natecvt/Team-303/docs/Programming Resources.md

# Programming Resources

- [AprilTag Library](https://github.com/AprilRobotics/apriltag)
- [Python Socket Interface](https://docs.python.org/3/library/socket.html)
- [Python Docs](https://docs.python.org/3/)
