natecvt/Team-303/docs/mangraph.png

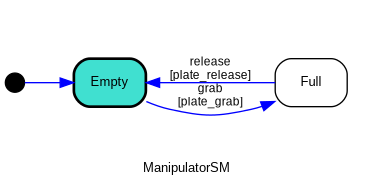
docs/mangraph.png
