natecvt/Team-303/docs/posgraph.png

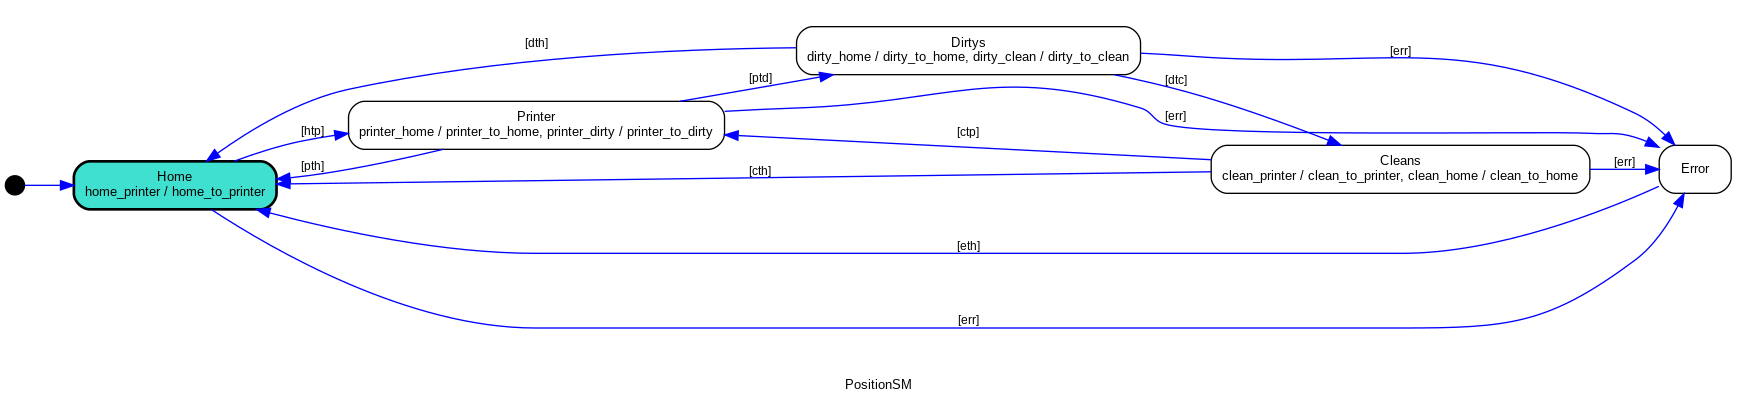
docs/posgraph.png
