natecvt/Team-303/Fusion Files/_Concept Workspace -NC.812245d1-37e7-4239-b554-420e8f00313b.png

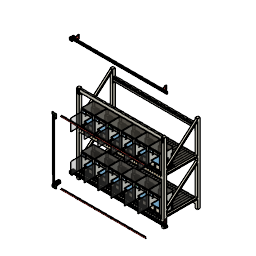
Fusion Files/_Concept Workspace -NC.812245d1-37e7-4239-b554-420e8f00313b.png
