natecvt/Team-303/Fusion Files/_Nate's Plate Dispenser.ac4d981b-2b22-4684-8131-7b73c1c8784d.png

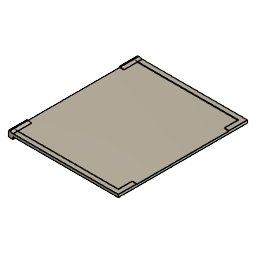
Fusion Files/_Nate's Plate Dispenser.ac4d981b-2b22-4684-8131-7b73c1c8784d.png
