natecvt/Team-303/Fusion Files/_Z Arm Copy.522619a4-56e4-46a4-9503-2a1cf247f2d2.png

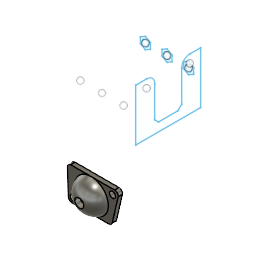
Fusion Files/_Z Arm Copy.522619a4-56e4-46a4-9503-2a1cf247f2d2.png
