natecvt/Team-303/Fusion Files/_Z Arm Copy_Component2.59cd4705-7b90-461e-99cb-14aab5ead7ad.png

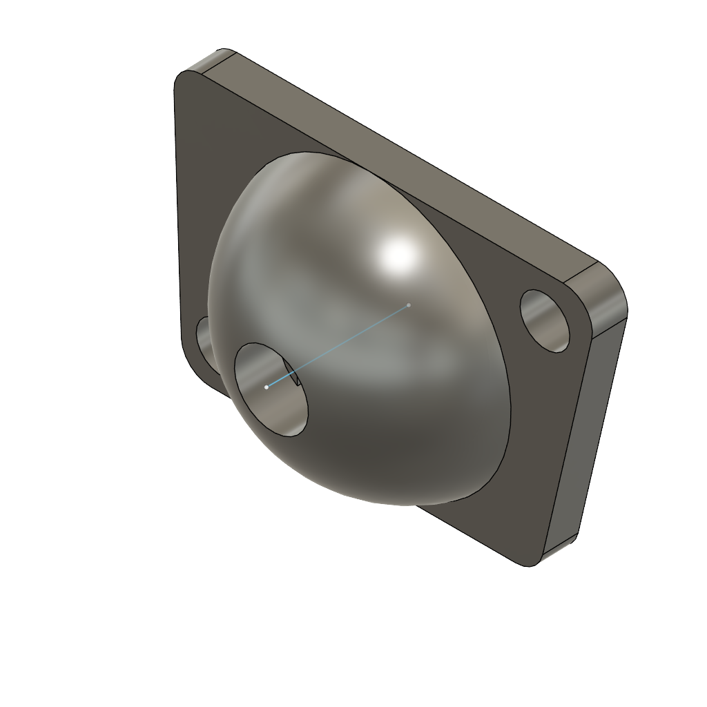
Fusion Files/_Z Arm Copy_Component2.59cd4705-7b90-461e-99cb-14aab5ead7ad.png
