natecvt/Team-303/(list of files, cad)

Other CAD files:
Fusion Files/_11435A13 Steel Drawer Slides.f201e1a2-71bf-47c2-941a-5dbec80e6ac8.f3d
Fusion Files/_1524-0001-0001 assembly.d8f83b15-5d64-45f2-8464-23ac5ebec497.f3d
Fusion Files/_1MEX1AUDCOXB63RKXOONYMDRDen-US11.871f0460-c664-4760-81d9-ae601f0fbb97.f3d
Fusion Files/_1_4_ x 1-1_2_ x 48_ Wood.e3c73d7b-7f3b-413b-bdec-7eca03abb7ca.f3d
Fusion Files/_2020 Extrusion.d20cdcef-b238-4049-98ed-29df6a03594f.f3d
Fusion Files/_2CWA9TJD5Y5ZICN82B6K2HIVUen-US11.b4c415c8-f10c-463e-afa1-e01077a5fb48.f3d
Fusion Files/_2LRKZU0XQ3TFWOJJPE8VZ6TH7en-US11.e4896452-3879-4eb4-a955-ac26621a7747.f3d
Fusion Files/_2YGZ0ALZRLHQGKKM6CFQO6XRRen-US11.6d42b6b1-727e-4e6d-b5a9-baa54112e666.f3d
Fusion Files/_2x4 board.d99266e9-60ea-4329-bf0e-f758237543eb.f3d
Fusion Files/_3030 Angle Bracket.8fdec9af-f8a9-4786-83be-04986f9cd556.f3d
Fusion Files/_30mm x 60mm Profile v4.02e2be94-0d6a-477b-a073-dc361f5778b3.f3d
Fusion Files/_34HP29-6004S.21105655-74dc-47f4-a5a2-57e6708c8cfd.f3d
Fusion Files/_34HS38-4204D.5b6d3bde-a94a-41b2-8553-8acd5e45f75a.f3d
Fusion Files/_3DBenchy.6bf22c53-5d7d-44a3-8f2e-c1a7761ff799.f3d
Fusion Files/_4OEEJIF0B9PPVZ418O6PRQBIKen-US11.62161f97-23c2-4399-a1da-700cbc7e6848.f3d
Fusion Files/_5-Axis_interface_Board.dd792416-b463-42a2-9a4e-d865812135e1.f3d
Fusion Files/_608_bearing_loose Drawing.7d569181-074e-4e86-8065-ec56b04d2bd5.f2d
Fusion Files/_608_bearing_loose Drawing.fba835c8-0b00-4eb9-9039-403241976642.f2d
Fusion Files/_608_bearing_loose.4b137e7b-a010-4bac-929f-4559a8e0e562.f3d
Fusion Files/_6121 TMC2209 Driver.b4bf99a3-9f4d-47f9-b455-627c43442d4c.f3d
Fusion Files/_8KEYWE6RKB4RY3AVARTBXGBUTen-US11.58c39408-2f88-4fb6-8834-311d7a520ea7.f3d
Fusion Files/_AF2L2LL72Y6KH69GZKG6OXJIJen-US11.b8a858b2-0cdd-422f-bf79-8eb3990d1fa5.f3d
Fusion Files/_APEX_AB090A.dff36a9a-ec71-4ef7-bbd9-a6e3a0eaae9f.f3d
Fusion Files/_ARZAPX611HE4EJA0GVGFHWCEDen-US11.91fedfdf-b78a-491f-80bd-0d916006fc69.f3d
Fusion Files/_Acryllic Bottom Panel.a2e647fa-4541-49cd-8f14-f221a0b68c71.f3d
Fusion Files/_Alumunium Profile 3030.5e9db2a2-b4c8-4faa-b999-057ec7ec6fd7.f3d
Fusion Files/_Animation Test Print.c652fa5c-e650-4809-80f6-2eb2ca7b7716.f3d
Fusion Files/_BEARING.36e73cc2-2726-468c-967d-a39445ba801f.f3d
Fusion Files/_BED LIFTER v6.47b509fa-7b62-4dd1-9dec-8417c735d87a.f3d
Fusion Files/_Bambu X1C.0ba0961a-6383-4ad6-a3a4-08fed4a4a26a.f3d
Fusion Files/_Bambu X1C.2f27f083-a404-4860-91cc-b01bfa1a344a.f3d
Fusion Files/_Bambu X1C.ee5c8159-9735-4650-8eb5-f683d6820118.f3d
Fusion Files/_BarBeam.5c540dc0-49b3-424c-a6fa-f8eb28995f75.f3d
Fusion Files/_Bearing Assembly.18e97cce-70fd-4f5a-a665-227e1e79b88c.f3d
Fusion Files/_Bearing Assembly.c613765f-da20-447d-8ce3-f9d2aa04a9a1.f3d
Fusion Files/_Bearing.9ad38aa8-b4c1-4b58-a255-3b9564d2ce1e.f3d
Fusion Files/_Belt Tension Spacer Drawing.256da694-22c8-4e23-9ec9-d312e222b278.f2d
Fusion Files/_Belt Tension Spacer.d0077247-6966-45b5-a952-ba4797ad4160.f3d
Fusion Files/_Bolt Ramp Cover.b14d74ff-13b3-4bcc-bf03-41ef3c5aef0e.f3d
Fusion Files/_Bottom Grip Drawing.aa5d0a74-4aea-4fbf-97d2-10af25b1910b.f2d
Fusion Files/_Bottom Grip.d06de344-5b7f-4842-80e2-1f2c50bef981.f3d
Fusion Files/_Bottom Gripper - PETG.6541a5cc-7aaf-420e-b20c-d6b1b9675311.f3d
Fusion Files/_Bushing.d676b754-ac8c-492a-baaf-132cd2dec664.f3d
Fusion Files/_CBDV84A8I0WL1YNSBZLN71LCOen-US11.f75e25f6-2e55-49c4-8258-774282cb3d49.f3d
Fusion Files/_Carriage - PLA.e418e02d-878d-4828-aee4-d5c6400d76ea.f3d
Fusion Files/_Carriage.0b2b4e1a-04e9-4fef-95d4-fc130978fd02.f3d
Fusion Files/_Center Disk - PLA(UNPRINTED).b0c9f04e-1c23-4f4a-89ec-b8c6ccbb50af.f3d
Fusion Files/_Clean Plate Dispenser IV.00e3d409-83d6-4102-95ea-da3b694405df.f3d
Fusion Files/_Clean Plate Dispenser Mk I.d888115d-f9dc-4e2e-b37e-09149f3ba2da.f3d
Fusion Files/_Clean Plate Dispenser Mk II.aa286063-0900-4341-9739-145c506a401d.f3d
Fusion Files/_Clean Plate Dispenser Mk II.c28ebf26-b3f7-4ca9-b64e-0c7db7e6fd58.f3d
Fusion Files/_Clean Plate Dispenser Mk III -CB.3465c587-4609-48bf-b0e1-33bd404df41b.f3d
Fusion Files/_Clean Plate Dispenser Mk III.bc16b3c2-3918-4c6a-9620-ba4c95044fed.f3d
Fusion Files/_Clean Plate Dispenser Mk IV.07862242-1453-423a-8027-b55cac08dfaa.f3d
Fusion Files/_Clean Plate Dispenser Mk VI.50b04678-366e-420a-94e1-b5dc8567d541.f3d
Fusion Files/_Clean Plate Dispenser Mk VI.872e23aa-c2f2-444b-ac29-6d9ff279327c.f3d
Fusion Files/_Clean Plate Dispenser Mk VI.986346c8-7c10-4720-974b-1816f312ca2f.f3d
Fusion Files/_Clean Plate Dispenser Mk VII Drawing.3a0c4c97-41eb-437a-b866-73dc83d58730.f2d
Fusion Files/_Clean Plate NEMA 17 w_ Lead Screw.d50ca21d-fa27-44c8-b5f9-0d5c7d1bbd7b.f3d
Fusion Files/_Clean Plate Shelf Board.2b175231-a27d-466f-826b-acb84cc05703.f3d
Fusion Files/_Concept Workspace -CB_CPD & E-Shelf.488b2424-6ffc-4902-bf2d-4ff15675e1c4.f3d
Fusion Files/_Connecting Bracket - PETG(UNPRINTED).d62f7203-87be-4ffc-b4af-6a76f50e32fd.f3d
Fusion Files/_Connecting Bracket and Door Peg - PETG.c4a71934-b0d0-4ee0-bcbc-1e1dc2b2d839.f3d
Fusion Files/_Corner Mount (BL) - PLA(UNPRINTED).6a92bf0e-be94-499f-afa5-f4096df500e7.f3d
Fusion Files/_Corner Mount (BR) - PLA(UNPRINTED).cc1ebedb-9e60-4fe5-a2ff-01e3a96ac505.f3d
Fusion Files/_Corner Mount (FL) - PLA(UNPRINTED).6153c898-196f-4466-89e3-3e98568611da.f3d
Fusion Files/_Corner Mount (FR) - PLA(UNPRINTED).944a5cd2-0263-4eac-8404-031c68dc65f3.f3d
Fusion Files/_Cross Bar.9fb02594-36a0-4474-9139-e6fe5210b81d.f3d
Fusion Files/_Cryogrip Pro Glacier Print Plate.e03662f8-7f37-4dec-8051-359863a2ac5f.f3d
Fusion Files/_D6H5TS5AVR8F43N3R1XL613M4en-US11.c9319d48-3e45-4f47-b580-171f8668bec4.f3d
Fusion Files/_DC–DC Converter (Output—12V20A).7ef1258a-59f4-465b-95e3-1039faef6fbb.f3d
Fusion Files/_DM860D.acb2b8d5-bf62-48d1-a249-f7f316a14808.f3d
Fusion Files/_Dirty Plate Panel Assembly (Double Sided).1f15971e-c9f7-46a8-bb4e-32e216f44586.f3d
Fusion Files/_Dirty Plate Panel Assembly (Left End).fb309c1f-d267-43c5-8591-1b8af36e7ebe.f3d
Fusion Files/_Dirty Plate Panel Assembly (Right End).6586db5a-2d80-4c8e-9abb-96794e564158.f3d
Fusion Files/_Door Peg - PETG(UNPRINTED).eb54a9cc-154b-4bd0-99ef-7f5174c7dbb0.f3d
Fusion Files/_Door Peg Arm Drawing.d310bc12-9456-4d6b-a5a6-582d7c525310.f2d
Fusion Files/_Door Peg Arm.c15aca6d-5e2f-43a4-9bdd-879f0cbf9eb8.f3d
Fusion Files/_Door Peg Drawing.fe2e4660-0dbb-4004-984a-58babb9493bb.f2d
Fusion Files/_Door Peg.04528239-56f7-4be8-bebd-5ac3028784df.f3d
Fusion Files/_Door handle.e58d4f98-5379-45a3-b839-1e9d1d2cf471.f3d
Fusion Files/_DoorHandle Drawing.80f49713-780c-46c9-81b8-1306e775f9b3.f2d
Fusion Files/_DoorHandle.e51096b4-f168-460e-9366-637bbbfa7daa.f3d
Fusion Files/_Drawer Slide Platform Drawing.74e53d03-3bf8-4873-bbfd-aae8dae7872d.f2d
Fusion Files/_Drawer Slide Platform Drawing.bd870e49-7afc-483a-8d96-bc4633aa2fe3.f2d
Fusion Files/_Drawer Slide Platform.ed80e009-23af-4e0c-9145-038d78873132.f3d
Fusion Files/_EStop Mount.2c2b779b-0f7c-4221-b780-935d777d9daa.f3d
Fusion Files/_EStop_LA38 _203 209B.204cfa63-6cc7-4e90-86a4-f45930ce202f.f3d
Fusion Files/_F4VPWOYM75PIA5HG82ETZLPW2en-US11.d6342356-7cd7-46d0-9618-566e6af3abb9.f3d
Fusion Files/_Final Assembly.d5e50cc4-fbbf-425d-9114-7c4eaf0d9d1f.f3d
Fusion Files/_Forklift Gripper.6b1c0e55-7617-40bb-bc85-293bfe7535c7.f3d
Fusion Files/_Forklift Gripper.78eb993c-dedf-4589-a54b-33957d6280ca.f3d
Fusion Files/_Forklift Gripper.8774358a-8fbf-4f9f-a7da-25711d0c93cd.f3d
Fusion Files/_Forklift Gripper.9c7cf6f4-ab22-4ea9-99b3-d0b801f71103.f3d
Fusion Files/_Forklift Gripper.aff1238d-7b78-4385-8f14-e939a9be44ff.f3d
Fusion Files/_GT2 Aluminum Timing Belt Clamp.340c6122-af78-4eda-ad23-d4842b9db6dc.f3d
Fusion Files/_GT2_30T_8mm-Bore_6mm-Belt v2.571befc2-2a2b-4837-bd41-15348b01cf62.f3d
Fusion Files/_GT2_30T_8mm-Bore_6mm-Belt v2.9e95242d-53cf-47ee-bd2e-521d65de6457.f3d
Fusion Files/_GT2_Belt_Tensioner_2020.30771677-e502-4594-9bbf-6fb2553483e7.f3d
Fusion Files/_GT2_Belt_Tensioner_2020.92cd986f-2bba-4732-beba-4abccc0f6408.f3d
Fusion Files/_Gantry Assembly.24bbb05c-2e5b-47de-b62c-a8f817f25a81.f3d
Fusion Files/_Gantry Carriage Drawing.be659053-b998-46e8-ba02-e66b1a41b0d9.f2d
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
