natecvt/Team-303/Fusion Files/_Y Axis + Z Axis Assembly.4d20c737-85af-49aa-a7bc-ecfc3bc29eaa.png

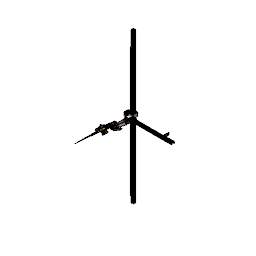
Fusion Files/_Y Axis + Z Axis Assembly.4d20c737-85af-49aa-a7bc-ecfc3bc29eaa.png
