natecvt/Team-303/ref_files/config.yaml

axis_x_max: 2740.0
axis_y_max: 1220.0
axis_z_max: 420.0
camera_fov_height: 40.0
camera_fov_length: 50.0
camera_global_transform:
- x: -70.6
- y: 64.5
- z: 50.0
camera_transform_coeffs:
- x: -50.0
- y: -15.0
clean_plate_axis: v
clean_plate_distance: 215.0
cs_amount: 5
cs_coords:
  x: 2353.007433437003
  y: 755.7050812168577
cs_grab_y: -30.0
cs_grab_z: 350.9547763247974
cs_tag_id: 0
door_close_delta:
  x: 325.0
  y: 0.0
  z: 283.0
door_close_x_offset: 15.0
door_into_y: 35.0
door_open_delta:
  x: -340.0
  y: 0.0
  z: -280.0
door_radius: 310.0
door_to_plate_delta:
  x: -50.0
  y: 68.0
  z: 0.0
door_z: 395.0
ds_amount_per: 4
ds_angle: -13.0
ds_cols: 6
ds_cols_coords:
  1:
    x: 0.1
    y: 0.1
  2:
    x: 0.1
    y: 0.1
  3:
    x: 0.1
    y: 0.1
  4:
    x: 0.1
    y: 0.1
  5:
    x: 0.1
    y: 0.1
  6:
    x: 0.1
    y: 0.1
  7:
    x: 0.1
    y: 0.1
ds_coords:
  x: 377.86305188340134
  y: 778.1307565171763
ds_dx: 277.53408903693594
ds_dy: -81.22026800002561
ds_release_dy: -10.0
ds_release_z: 375.0
ds_rows: 4
feed_rate: 3000.0
gripper_axis: u
gripper_down: -15.1
gripper_up: 13.0
heartbeat_duration: 30.0
linuxcnc_folder: linuxCNC/team303_machine.ini
linuxcnc_timeout: 240.0
manipulator_angle_0: 895.0
manipulator_angle_90: 100.0
manipulator_angle_n12: 950.0
mqtt_acknowledge_topic: test/ack
mqtt_broker_ip: localhost
mqtt_complete_topic: test/complete
mqtt_error_topic: test/error
mqtt_heartbeat_topic: test/heartbeat
mqtt_keepalive: 120
mqtt_received_topic: test/topic
mqtt_storage_topic: test/storage
printer_coords:
  1:
    x: 486.3253384055591
    y: 37.88888240607261
  2:
    x: 1887.015173546095
    y: -5.289912223815918e-06
printer_plate_z: 340.0
tolerance: 0.5
