natecvt/Team-303/linuxCNC/team303_machine.ini

# Generated by stepconf 1.1 at Wed Oct 18 19:03:20 2023
# If you make changes to this file, they will be
# overwritten when you run stepconf again
# max speed should be 715mm/minute or 12mm per second

[EMC]
MACHINE = cncRouter
DEBUG = 0
VERSION = 1.1

[DISPLAY]
DISPLAY = axis
EDITOR = gedit
POSITION_OFFSET = RELATIVE
POSITION_FEEDBACK = ACTUAL
ARCDIVISION = 64
GRIDS = 10mm 20mm 50mm 100mm 1in 2in 5in 10in
MAX_FEED_OVERRIDE = 1.2
MIN_SPINDLE_OVERRIDE = 0.5
MAX_SPINDLE_OVERRIDE = 1.2
DEFAULT_LINEAR_VELOCITY = 25.4
MIN_LINEAR_VELOCITY = 0
MAX_LINEAR_VELOCITY = 75.0
CYCLE_TIME = 0.200
INTRO_GRAPHIC = linuxcnc.gif
INTRO_TIME = 5
PROGRAM_PREFIX = /home/cnc/linuxcnc/nc_files
INCREMENTS = 5mm 1mm .5mm .1mm .05mm .01mm .005mm

[KINS]
#JOINTS = 3
#KINEMATICS = trivkins coordinates=XYZ
JOINTS = 5
KINEMATICS = trivkins coordinates=XYZUV

[FILTER]
PROGRAM_EXTENSION = .png,.gif,.jpg Greyscale Depth Image
PROGRAM_EXTENSION = .py Python Script
PROGRAM_EXTENSION = .nc,.tap G-Code File
png = image-to-gcode
gif = image-to-gcode
jpg = image-to-gcode
py = python

[TASK]
TASK = milltask
CYCLE_TIME = 0.010

[RS274NGC]
PARAMETER_FILE = linuxcnc.var

[EMCMOT]
EMCMOT = motmod
COMM_TIMEOUT = 1.0
BASE_PERIOD = 100000
SERVO_PERIOD = 660000

[HAL]
HALFILE = team303_machine.hal
HALFILE = custom.hal
POSTGUI_HALFILE = postgui_call_list.hal

[TRAJ]
#COORDINATES =  X Y Z
COORDINATES =  X Y Z U V
LINEAR_UNITS = mm
ANGULAR_UNITS = degree
DEFAULT_LINEAR_VELOCITY = 10.0
MAX_LINEAR_VELOCITY = 75.0

[EMCIO]
EMCIO = io
CYCLE_TIME = 0.100
TOOL_TABLE = tool.tbl

#*** AXIS_X *******************************
#STEPGEN_MAXACCEL should be up to 10% more than MAX_ACCELERATION
#MAX_VELOCITY is mm/s, MAX_ACCELERATION is mm/s^2
[AXIS_X]
MAX_VELOCITY = 75.0
MAX_ACCELERATION = 400.0
MIN_LIMIT = -1.0
MAX_LIMIT = 2740.0

[JOINT_0]
TYPE = LINEAR
HOME = 0.0
MIN_LIMIT = -1.0
MAX_LIMIT = 2740.0
MAX_VELOCITY = 75.0
MAX_ACCELERATION = 400.0
STEPGEN_MAXACCEL = 480.0
SCALE = -17.88
STEP_SCALE = -17.88
FERROR = 1.270
MIN_FERROR = .254
HOME_OFFSET = 0.0
HOME_SEARCH_VEL = -48.0
HOME_LATCH_VEL = 2
HOME_FINAL_VEL = 2
HOME_SEQUENCE = 1
#******************************************

#*** AXIS_Y *******************************
[AXIS_Y]
MAX_VELOCITY = 75.0
MAX_ACCELERATION = 400.0
MIN_LIMIT = -0.1
MAX_LIMIT = 1220.0

[JOINT_1]
TYPE = LINEAR
HOME = 0.0
MIN_LIMIT = -0.1
MAX_LIMIT = 1220.0
MAX_VELOCITY = 75.0
MAX_ACCELERATION = 400.0
STEPGEN_MAXACCEL = 480.0
SCALE = 17.88
FERROR = 1.270
MIN_FERROR = .254
HOME_OFFSET = 0.0
HOME_SEARCH_VEL = -48.0
HOME_LATCH_VEL = 2
HOME_FINAL_VEL = 2
HOME_SEQUENCE = 1
#******************************************

#*** AXIS_Z *******************************
[AXIS_Z]
MAX_VELOCITY = 75.0
MAX_ACCELERATION = 400.0
MIN_LIMIT = -0.1
MAX_LIMIT = 420.0

[JOINT_2]
TYPE = LINEAR
HOME = 0.0
MIN_LIMIT = -0.1
MAX_LIMIT = 420.0
MAX_VELOCITY = 75.0
MAX_ACCELERATION = 400.0
STEPGEN_MAXACCEL = 480.0
SCALE = -40
FERROR = 1.270
MIN_FERROR = .254
HOME_OFFSET = 0.0
HOME_SEARCH_VEL = -48.0
HOME_LATCH_VEL = 2
HOME_FINAL_VEL = 2
HOME_SEQUENCE = 0
#******************************************

#*** AXIS_U *******************************
[AXIS_U]
MAX_VELOCITY = 12.0
MAX_ACCELERATION = 100.0

[JOINT_3]
TYPE = LINEAR
HOME = 0.0
MAX_VELOCITY = 12.0
MAX_ACCELERATION = 100.0
STEPGEN_MAXACCEL = 120.0
SCALE = 160
STEP_SCALE = 160
FERROR = 1.270
MIN_FERROR = .254
#HOME_OFFSET = 0.0
#HOME_SEARCH_VEL = -10
#HOME_LATCH_VEL = 2
#HOME_FINAL_VEL = 2
# Disregard homing for this axis - not needed 
HOME_SEQUENCE = -1 
#******************************************

#*** AXIS_V *******************************
[AXIS_V]
MAX_VELOCITY = 12.0
MAX_ACCELERATION = 100.0

[JOINT_4]
TYPE = LINEAR
HOME = 0.0
MAX_VELOCITY = 12.0
MAX_ACCELERATION = 100.0
STEPGEN_MAXACCEL = 120.0
SCALE = 198.0
STEP_SCALE = -198.0
FERROR = 1.270
MIN_FERROR = .254
#HOME_OFFSET = 0.0
#HOME_SEARCH_VEL = -10
#HOME_LATCH_VEL = 2
#HOME_FINAL_VEL = 2
# Disregard homing for this axis - not needed 
HOME_SEQUENCE = -1
#******************************************
