natecvt/Team-303/(commit log)

2025-09-30 Uploaded a script for sizing stepper motors
2025-10-09 Added electrical peak script and input data
    [Electrical_Devices_Peaks.xlsx]
2025-10-10 Create Virginia Tech Gantry Integration - Interface Requirements Document
2025-10-10 Rename Virginia Tech Gantry Integration - Interface Requirements Document to Virginia Tech Gantry Integration - Interface Requirements Document.md
2025-10-10 Create Virginia Tech Gantry Automation - Implementation Guide.md
2025-10-31 Fixed stuff a little more
    [printer_centers.csv]
2025-10-31 Added the ability to see which printer is done and create a log file if an eror occurs.
2025-10-31 Fixed a couple things I had added previously.
2025-10-31 Added actions file to compile coordinates into gcodes
    [printer_centers.csv]
2026-03-21 Added LinuxCNC config files
    [team303_machine.hal, team303_machine.ini]
2026-03-21 Edited HAL and INI files and confirmed 5-axis works, still need PWM
    [team303_machine.hal]
2026-03-25 Added more functions to gantry_actions.py and more variables in config.yaml in ref files. Also changed gcode_gen slighty for the clockwise and counter-clockwise M codes
2026-03-27 mostly updated lcnc files
    [team303_machine.hal, team303_machine.ini]
2026-03-27 Fixed linuxcnc interface errors, confirmed python starts linuxcnc. Added all configurations to linuxcnc folder.
    [custom.hal, custom_postgui.hal, postgui_call_list.hal, pyvcp_options.hal]
2026-03-27 Created homing function and added entries to config
2026-03-27 Added MDI command interface and error checking. Updated config with a timeout, and fixed a bug in queue that only uses the test_loop in the worker thread
    [config.yaml]
2026-03-27 Fixed some things, confirmed functions
    [team303_machine.ini]
2026-03-29 Bunch of changes, started to implement apriltag autocalibration, fixed some issues with some sections, added much to the config file
    [config.yaml]
2026-03-30 Finalized testable auto-calibration functionality, and added coordinates writeable to config
    [printer_centers.csv]
2026-04-01 Added state machine functions, modified gantry actions to have a generic move, added some to config and storage tracker
2026-04-01 Started main file, modified some functions to prevent errors, tested multithreading capability
    [team303_machine.hal, team303_machine.ini]
2026-04-01 Added pseudo code for clean plate grab/release and position state machine and removed one redundant state transition
2026-04-02 Minor changes, converted gantry actions format to return a list of strings rather than one long one, created loop for multiple MDI lines
2026-04-03 Added function to modify config during runtime, added G17-19 in gcode gen, added function to check if z is zero in linuxcnc, reformatted gantry actions to include some checks, added constants read in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
2026-04-03 Added plate grabbing and fixed a few bugs in gcode gen
    [config.yaml]
2026-04-06 Gantry motions finalized
    [team303_machine.hal, team303_machine.ini]
2026-04-07 Main loop started, added some functionality to error message, changed state machine a bit
    [config.yaml]
2026-04-09 Safer linuxcnc modifications
    [team303_machine.hal]
2026-04-11 Added testing stuffs, implemented new mqtt messages, reformatted some threading code, added heartbeat thread, generalized publishing, added script for subscribing to many simultaneous mqtt topics
2026-04-11 Delay in heartbeat loop, would've published too much without
    [config.yaml]
2026-04-11 Clarify threading model and heartbeat functionality
    Updated the number of threads in the system description to three and added details about the heartbeat thread's functionality.
2026-04-13 Minimal modifications, seperated storage reset topic from normal sc, improcing storage handling. Fixed some bugs on outgoing messages. Changed ESTOP to home after errors. Added an Error state to stat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
    [config.yaml]
2026-04-15 Update error message clarification in README
    Clarified error message for full plate storage condition in README.
2026-04-15 Add configuration documentation for MQTT and printers
    This file outlines configuration values for MQTT and printer settings, including topics and movement parameters for the manipulator.
2026-04-19 Added calibration script
2026-04-20 Testing modifications, calibration script tentatively complete
2026-05-01 Modified calibration script for different functionality, added descriptions to the User Manual
2026-05-02 Modifications to add Apriltag functionality to calibration
2026-05-02 testing modifications
    [team303_machine.ini]
2026-05-06 Added all Fusion files, via LFS
    [_11435A13 Steel Drawer Slides.f201e1a2-71bf-47c2-941a-5dbec80e6ac8.f3d, _1524-0001-0001 assembly.d8f83b15-5d64-45f2-8464-23ac5ebec497.f3d, _1MEX1AUDCOXB63RKXOONYMDRDen-US11.871f0460-c664-4760-81d9-ae601f0fbb97.f3d, _1_4_ x 1-1_2_ x 48_ Wood.e3c73d7b-7f3b-413b-bdec-7eca03abb7ca.f3d, _2020 Extrusion.d20cdcef-b238-4049-98ed-29df6a03594f.f3d, _2CWA9TJD5Y5ZICN82B6K2HIVUen-US11.b4c415c8-f10c-463e-afa1-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]
